petelukk/kellorobo/continuous_track/4hammasta_testi.jpg

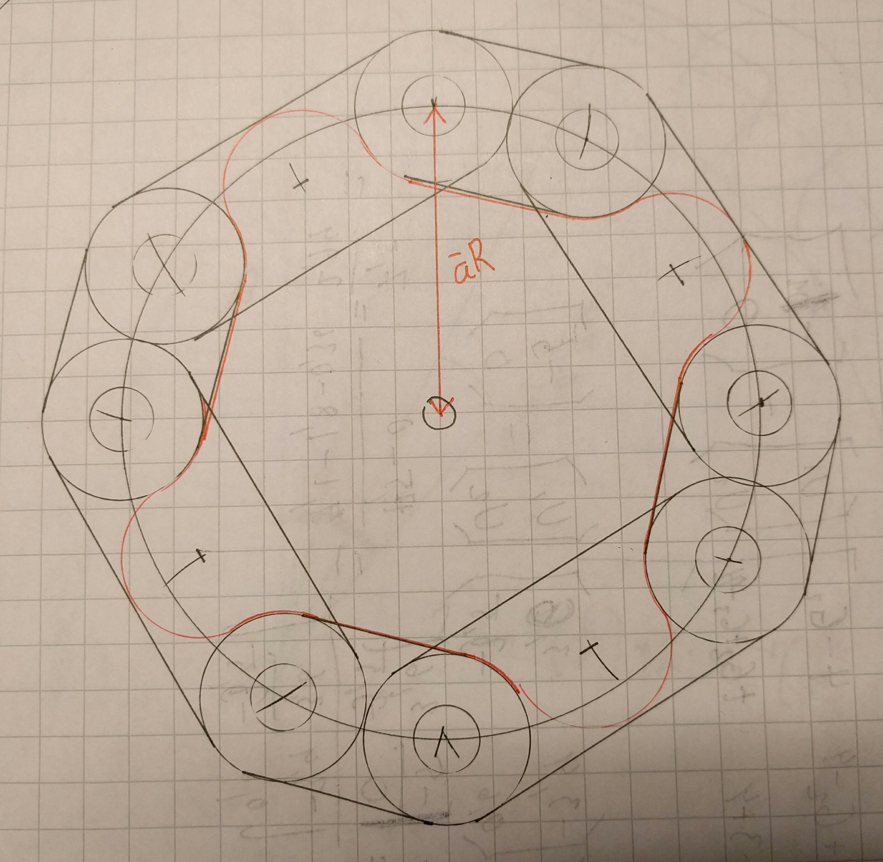
continuous_track/4hammasta_testi.jpg
