petelukk/kellorobo/kuvat/assembling_frame2.jpg

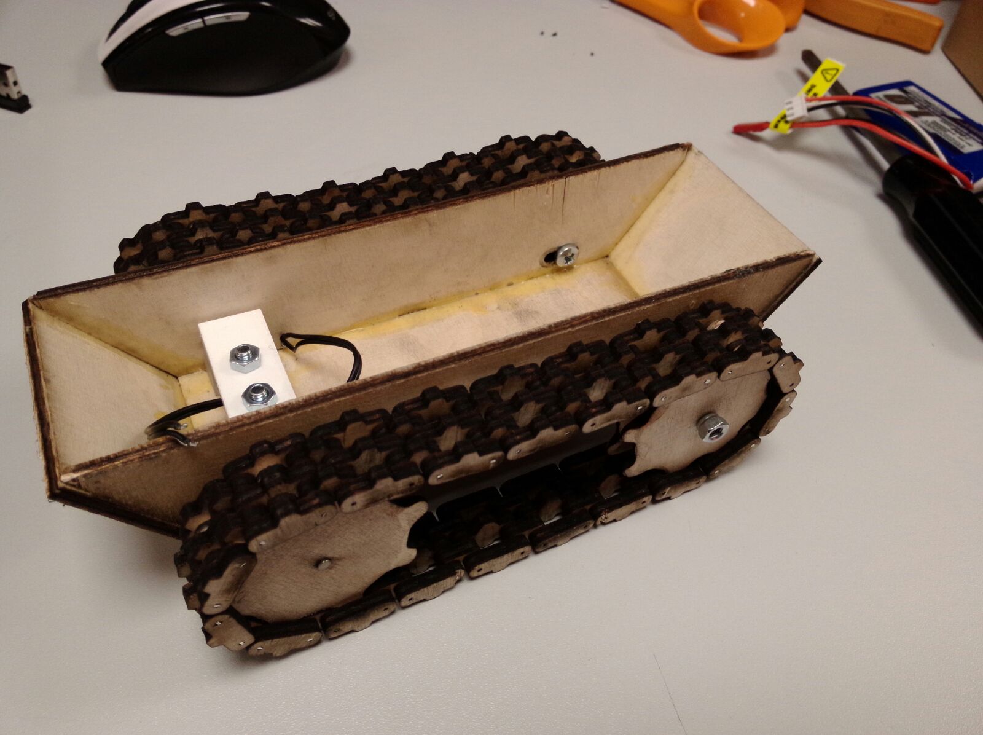
kuvat/assembling_frame2.jpg
