petelukk/kellorobo/workfiles/frame2.pdf

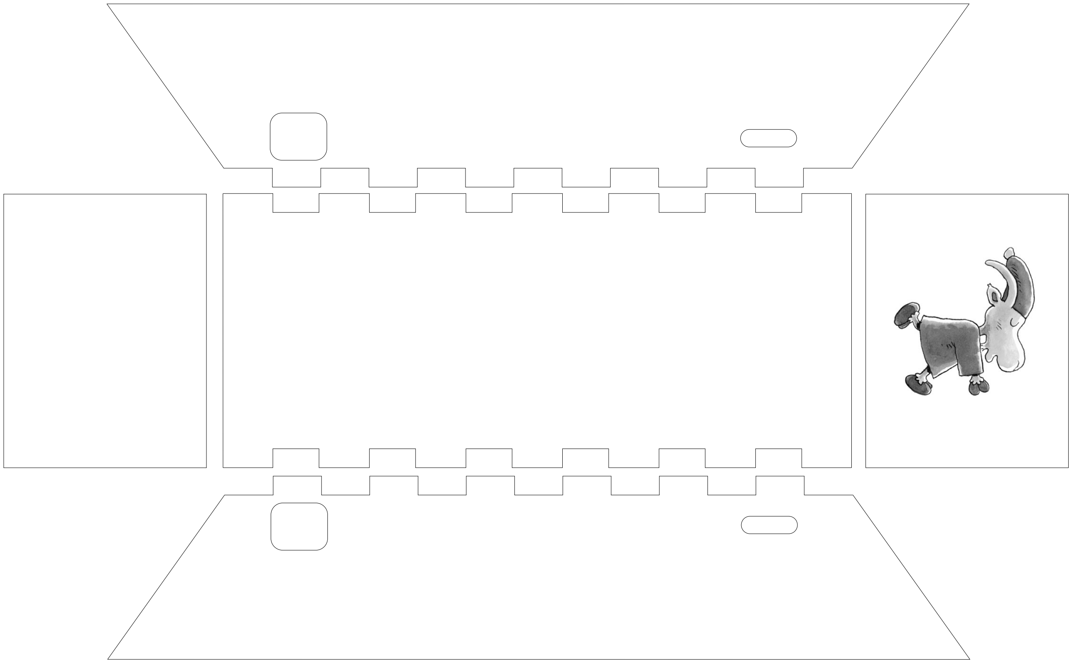
[picture p3: figure]
