petelukk/kellorobo/continuous_track/kaava.jpg

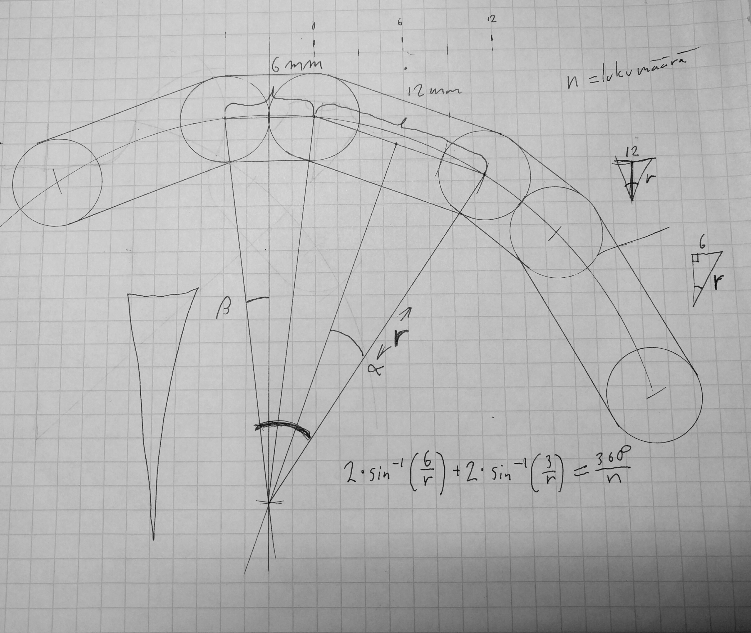
continuous_track/kaava.jpg
