petelukk/kellorobo/continuous_track/sprocket_freecad.png

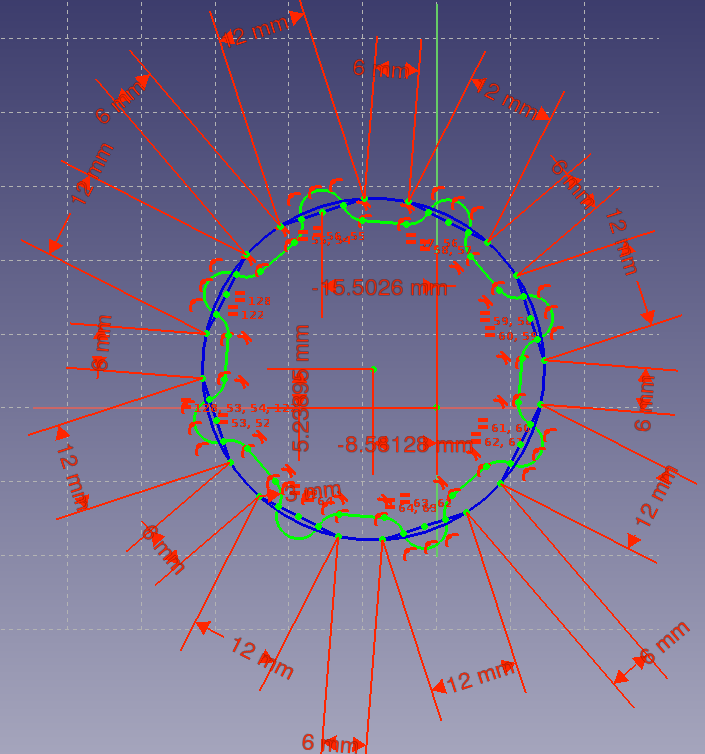
continuous_track/sprocket_freecad.png
