petelukk/kellorobo/kuvat/final1.JPG

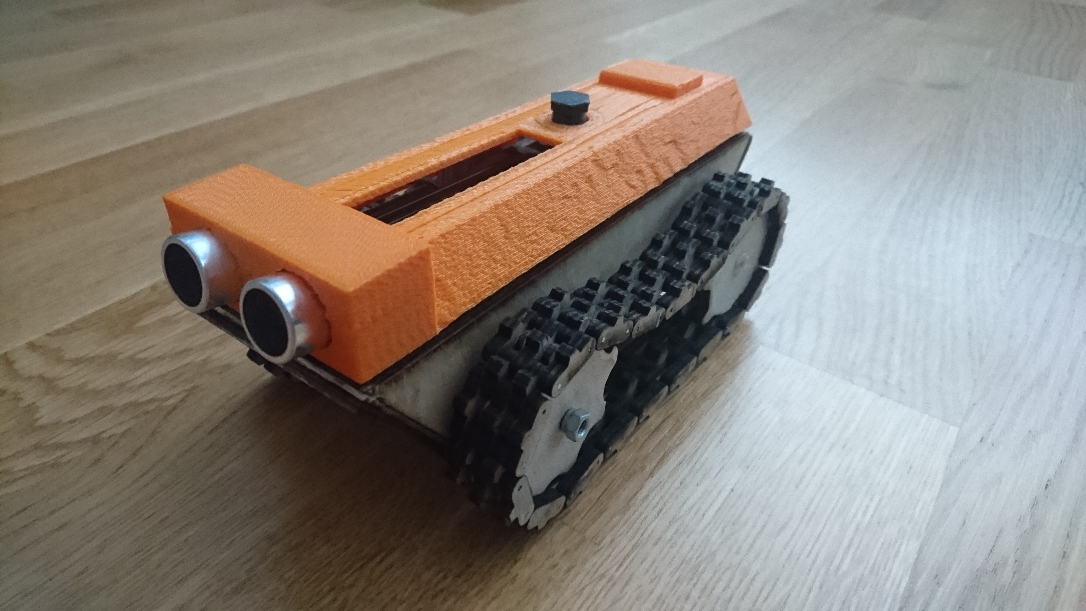
kuvat/final1.JPG
