petelukk/kellorobo/kuvat/final2.JPG

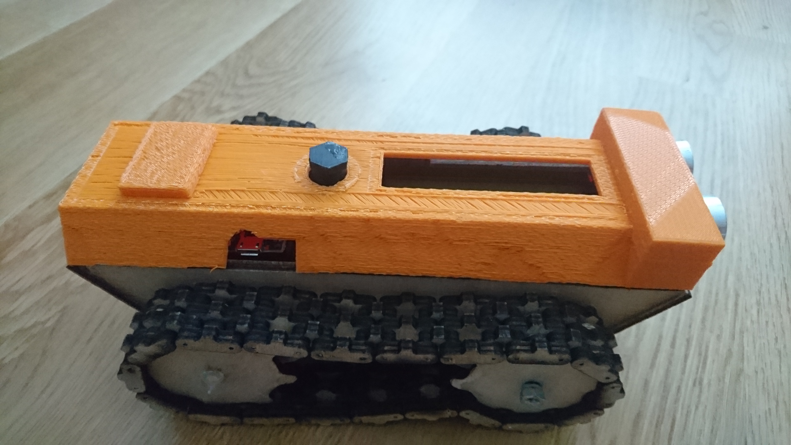
kuvat/final2.JPG
