petelukk/kellorobo/kuvat/final3.JPG

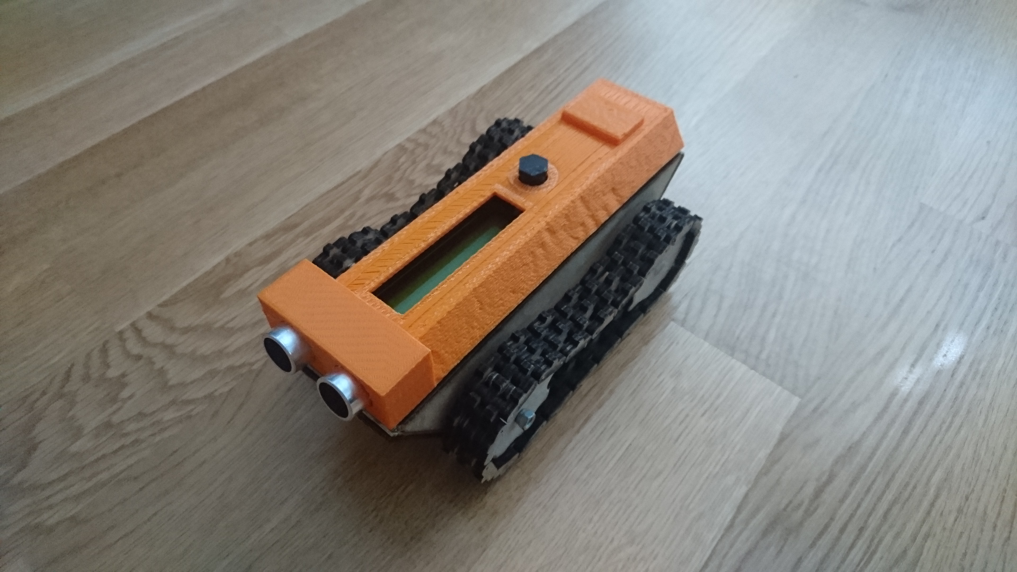
kuvat/final3.JPG
