petelukk/kellorobo/kuvat/final4.JPG

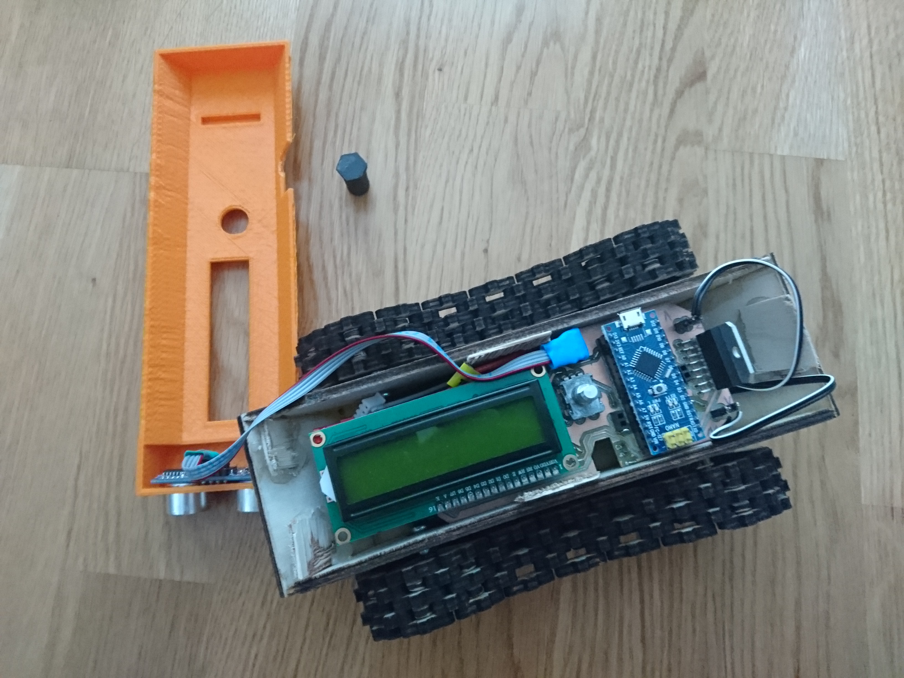
kuvat/final4.JPG
