petelukk/kellorobo/kuvat/final5.JPG

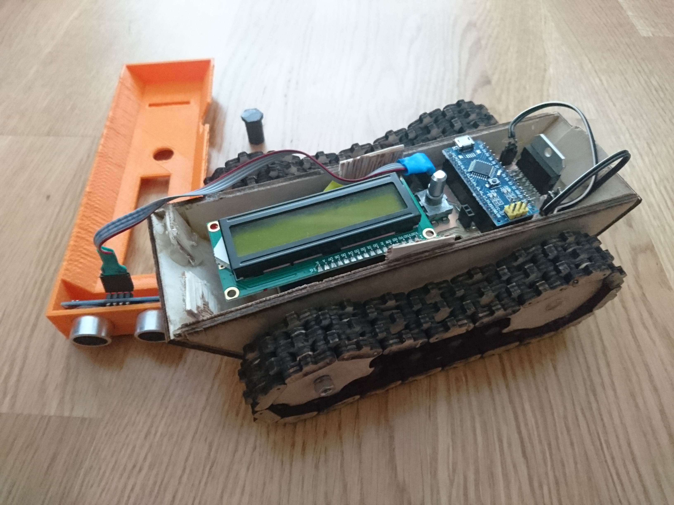
kuvat/final5.JPG
