petelukk/kellorobo/kuvat/final6.JPG

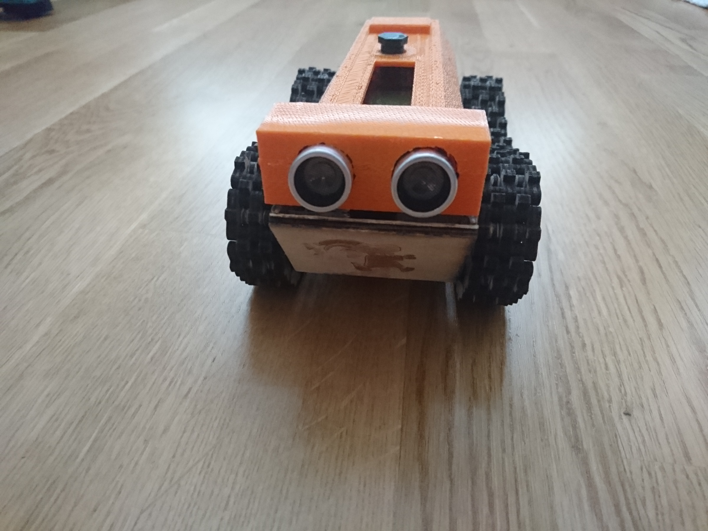
kuvat/final6.JPG
