petelukk/kellorobo/kuvat/frame2_with_tracks.jpg

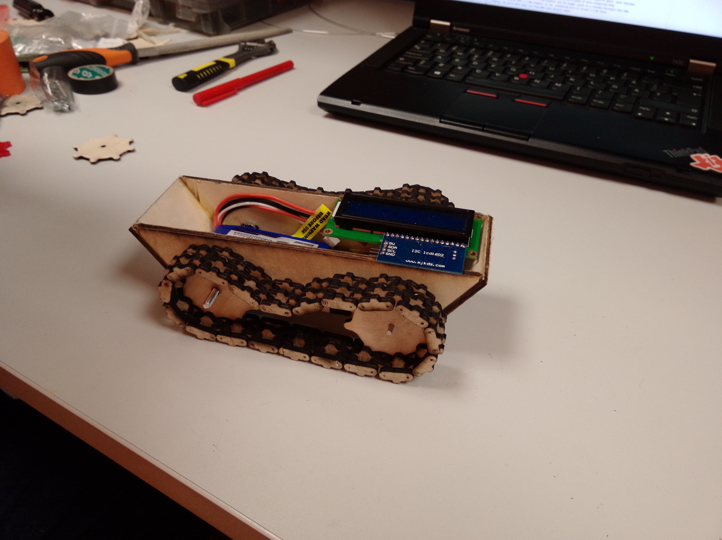
kuvat/frame2_with_tracks.jpg
