petelukk/kellorobo/kuvat/motor_holder.jpg

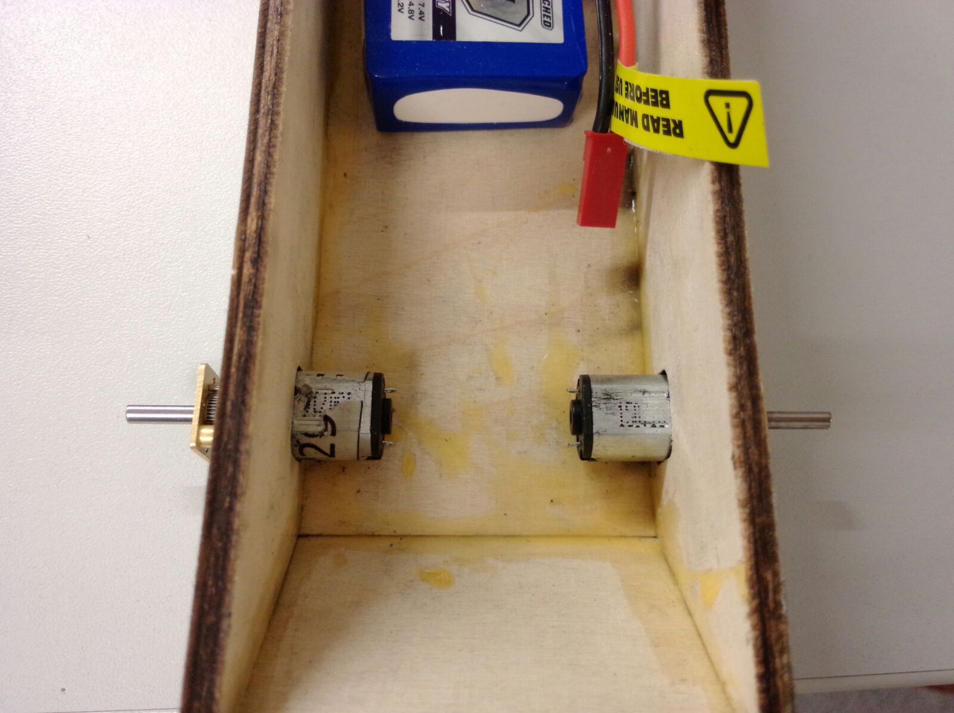
kuvat/motor_holder.jpg
