petelukk/kellorobo/kuvat/track_structure.jpg

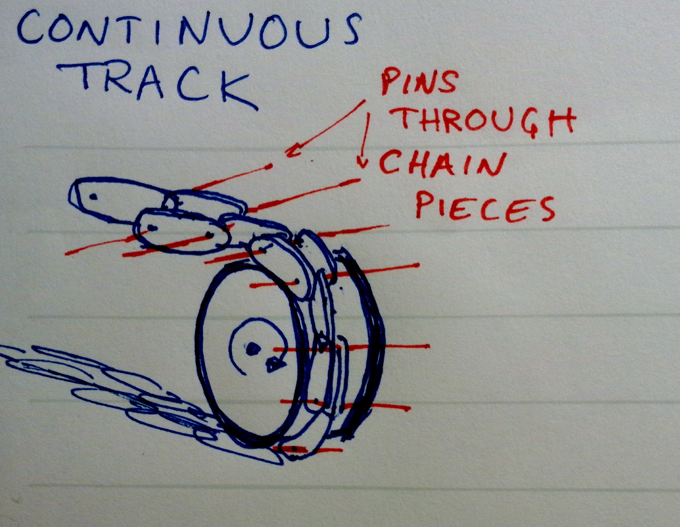
kuvat/track_structure.jpg
