petelukk/kellorobo/pcb/pcb_fäp_files/final/back_cu.png

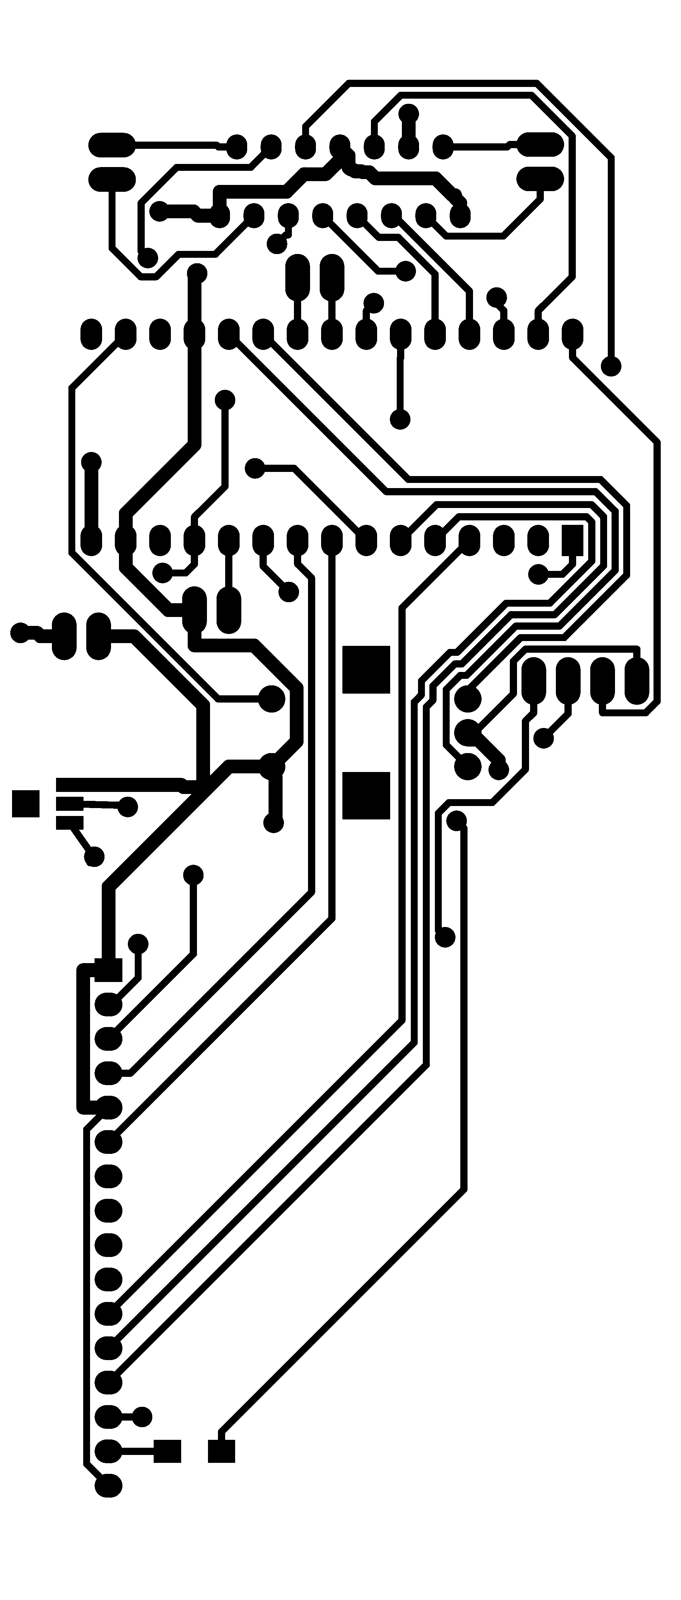
pcb/pcb_fäp_files/final/back_cu.png
