petelukk/kellorobo/pcb/pcb_fäp_files/final/edgecuts.png

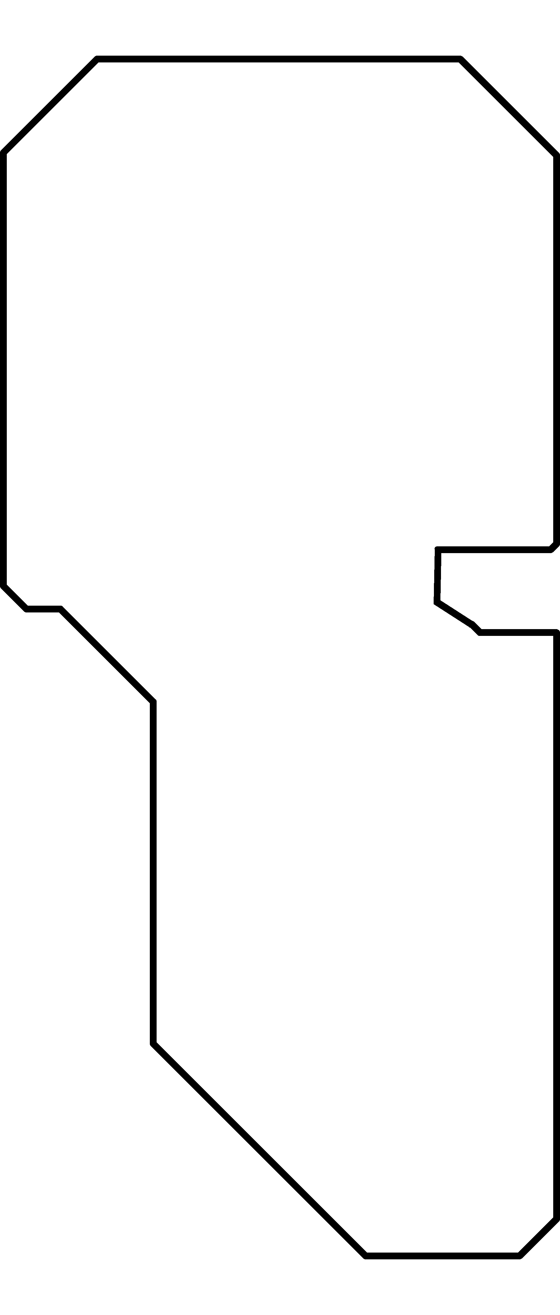
pcb/pcb_fäp_files/final/edgecuts.png
