petelukk/kellorobo/pcb/pcb_fäp_files/final/front_cu.png

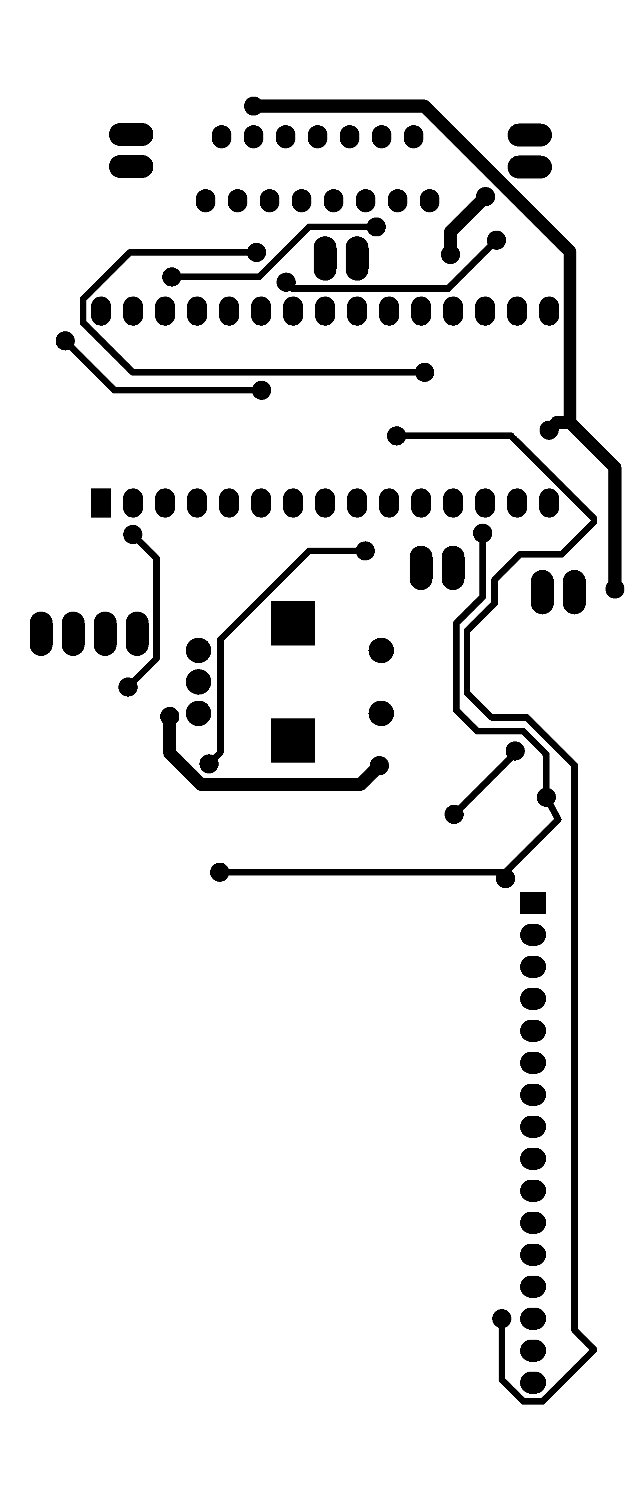
pcb/pcb_fäp_files/final/front_cu.png
