petelukk/kellorobo/pcb/pcb_fäp_files/final/holes_front.png

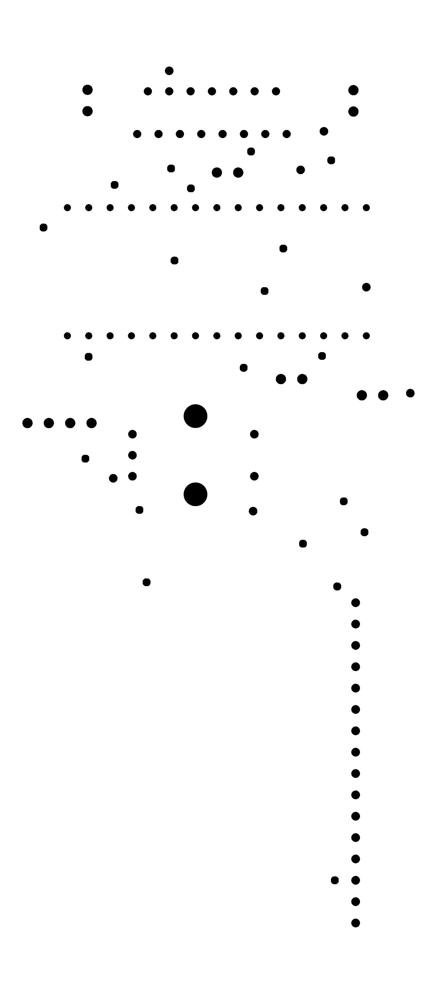
pcb/pcb_fäp_files/final/holes_front.png
