petelukk/kellorobo/workfiles/toplid_v3-cube.stl

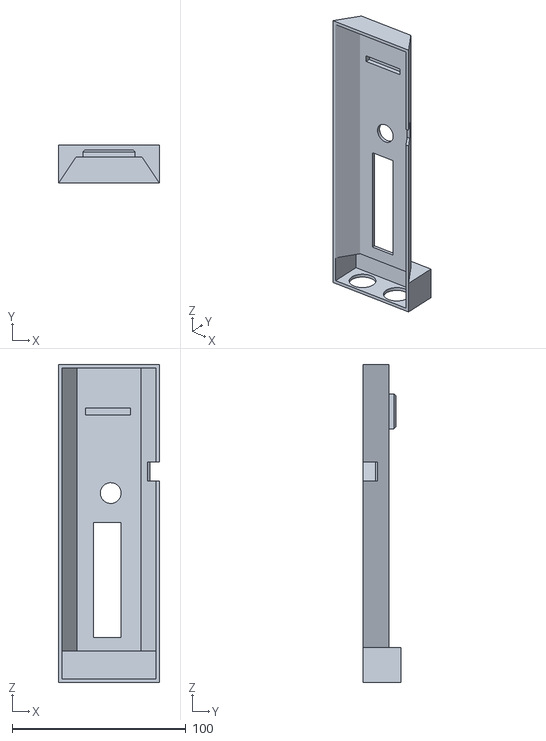
[picture p19: CAD file, 2016-06-07]
workfiles/toplid_v3-cube.stl
58.0 x 22.0 x 183.0
