petelukk/kellorobo/workfiles/rotary_knob.fcstd

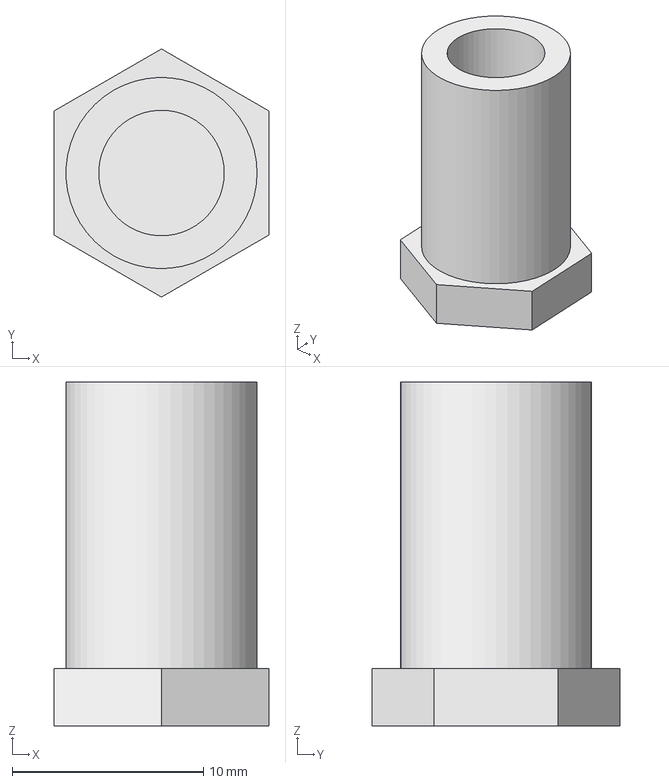
[picture p20: CAD file, 2016-06-07]
workfiles/rotary_knob.fcstd
11.2 x 13.0 x 18.0 mm
