petelukk/kellorobo/workfiles/motor_holder.fcstd

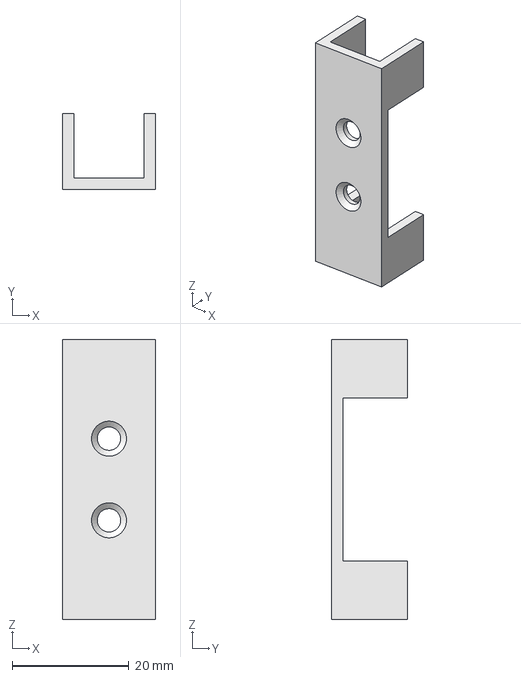
[picture p21: CAD file, 2016-04-21]
workfiles/motor_holder.fcstd
16.0 x 13.0 x 48.0 mm
