petelukk/kellorobo/(list of files, cad)

Other CAD files:
continuous_track/sprocket_freewheel.fcstd
continuous_track/sprocket_separator.fcstd
continuous_track/sprocket_motor_shaft.fcstd
workfiles/toplid_v3.fcstd
continuous_track/motor_axle_size_test.fcstd
continuous_track/sprocket.fcstd
continuous_track/sprocket_big_hole.fcstd
continuous_track/ketju.fcstd
continuous_track/middle_link.fcstd
continuous_track/side_link.fcstd
continuous_track/small_link.fcstd
workfiles/motor_holder.stl
workfiles/rotary_knob.stl
