petelukk/kellorobo/kuvat/assembling_frame.jpg

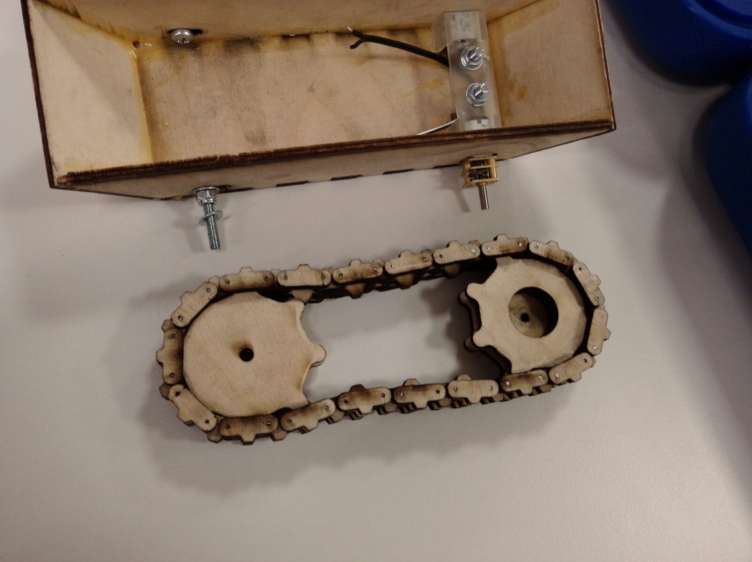
kuvat/assembling_frame.jpg
