petelukk/kellorobo/kuvat/motor_holder_printed.jpg

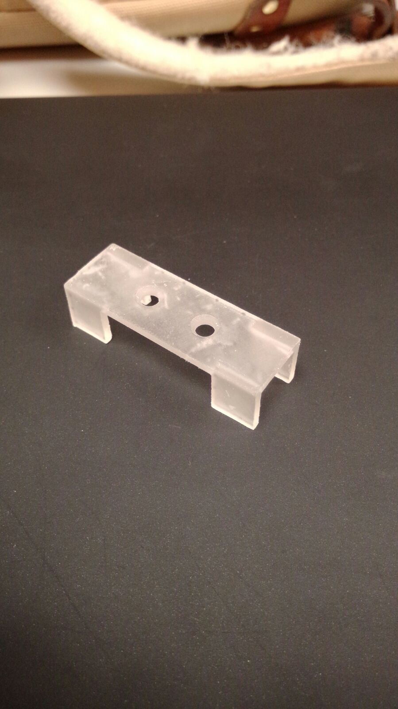
kuvat/motor_holder_printed.jpg
