petelukk/kellorobo/continuous_track/testi_svg.pdf

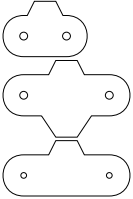
[picture p24: figure]
