petelukk/kellorobo/kuvat/cont_track_2nd_test2.jpg

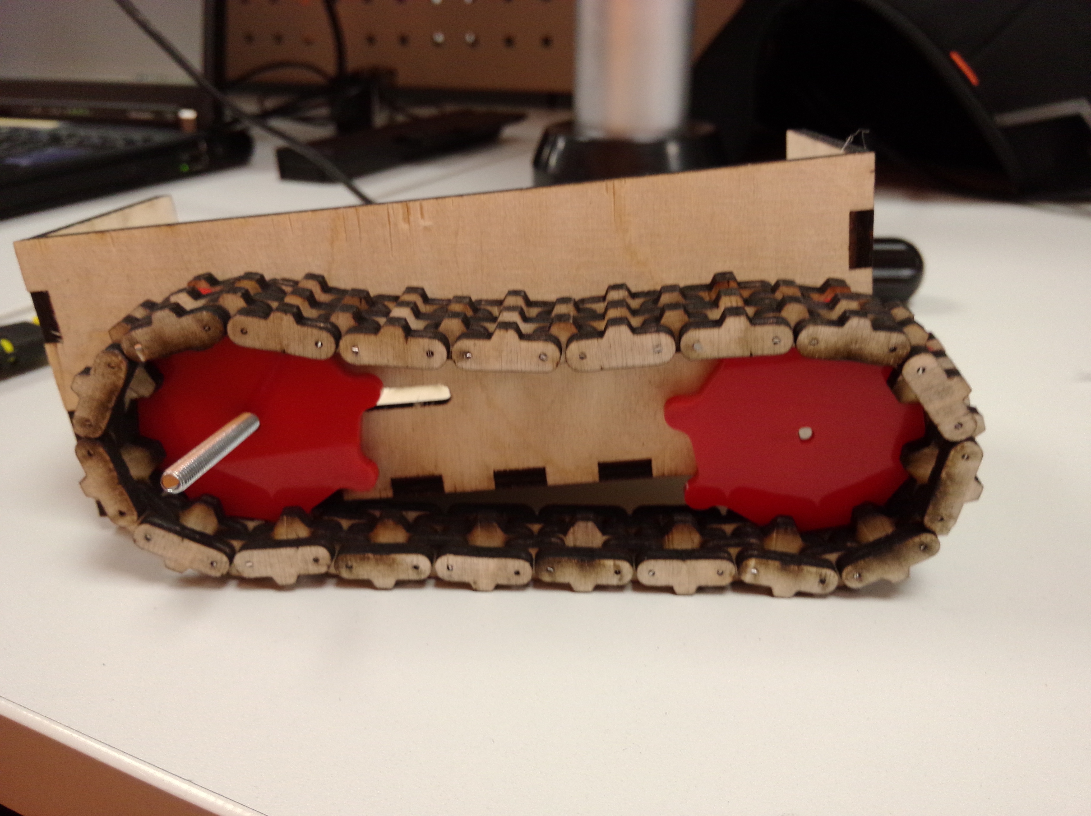
kuvat/cont_track_2nd_test2.jpg
