petelukk/kellorobo/kuvat/cont_track_2nd_test.jpg

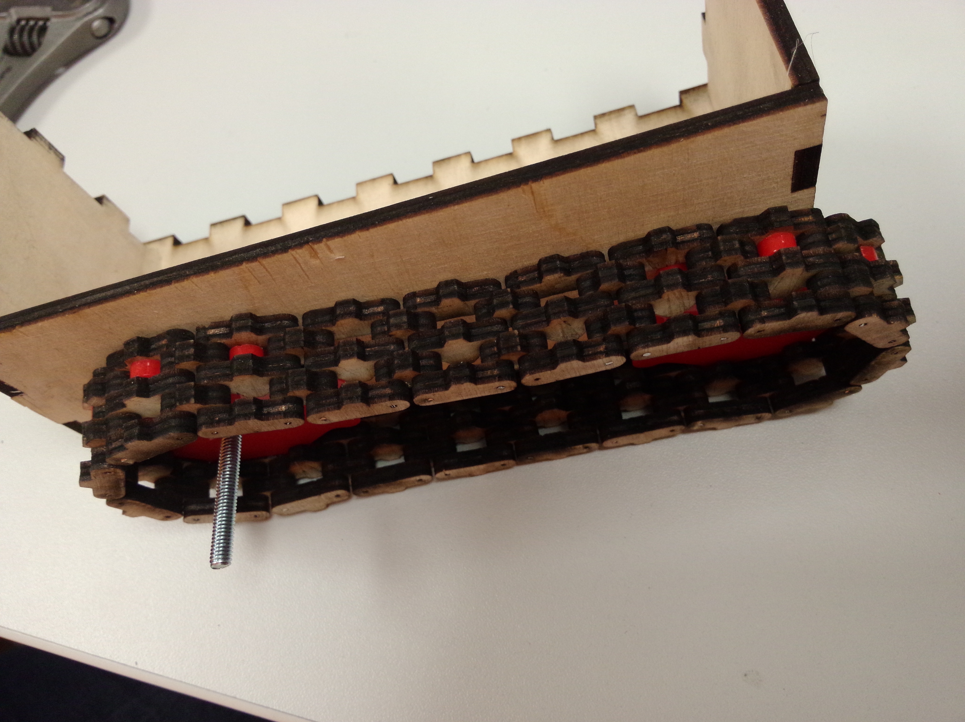
kuvat/cont_track_2nd_test.jpg
