petelukk/kellorobo/kuvat/cont_track_test1.jpg

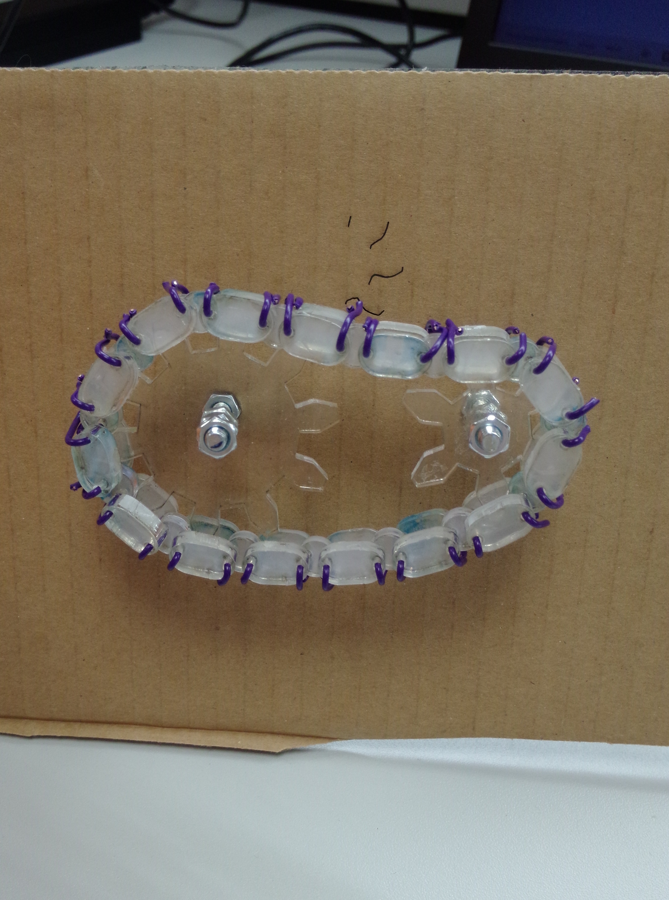
kuvat/cont_track_test1.jpg
