petelukk/kellorobo/kuvat/cont_track_test2.jpg

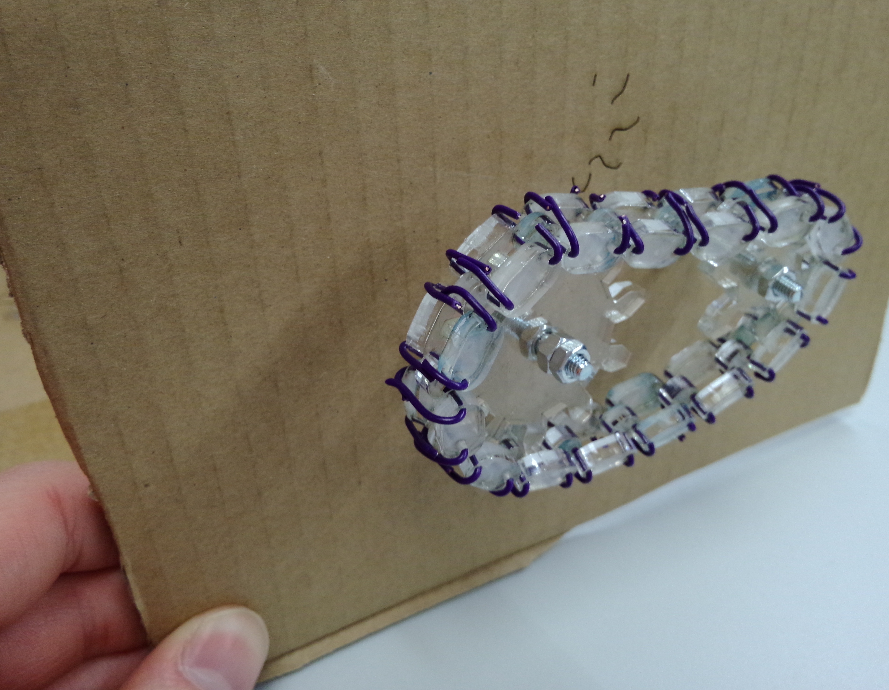
kuvat/cont_track_test2.jpg
