petelukk/kellorobo/workfiles/track_test2.pdf

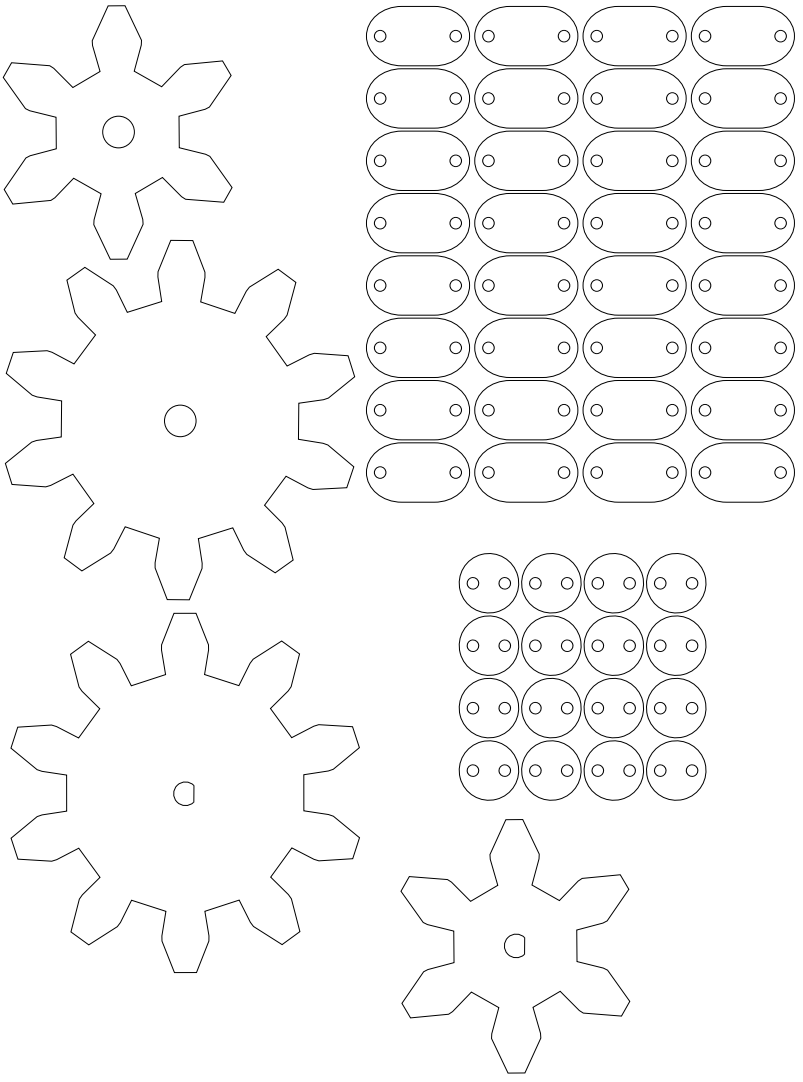
[picture p29: page 1]
