petelukk/kellorobo/continuous_track/sprocket_set.pdf

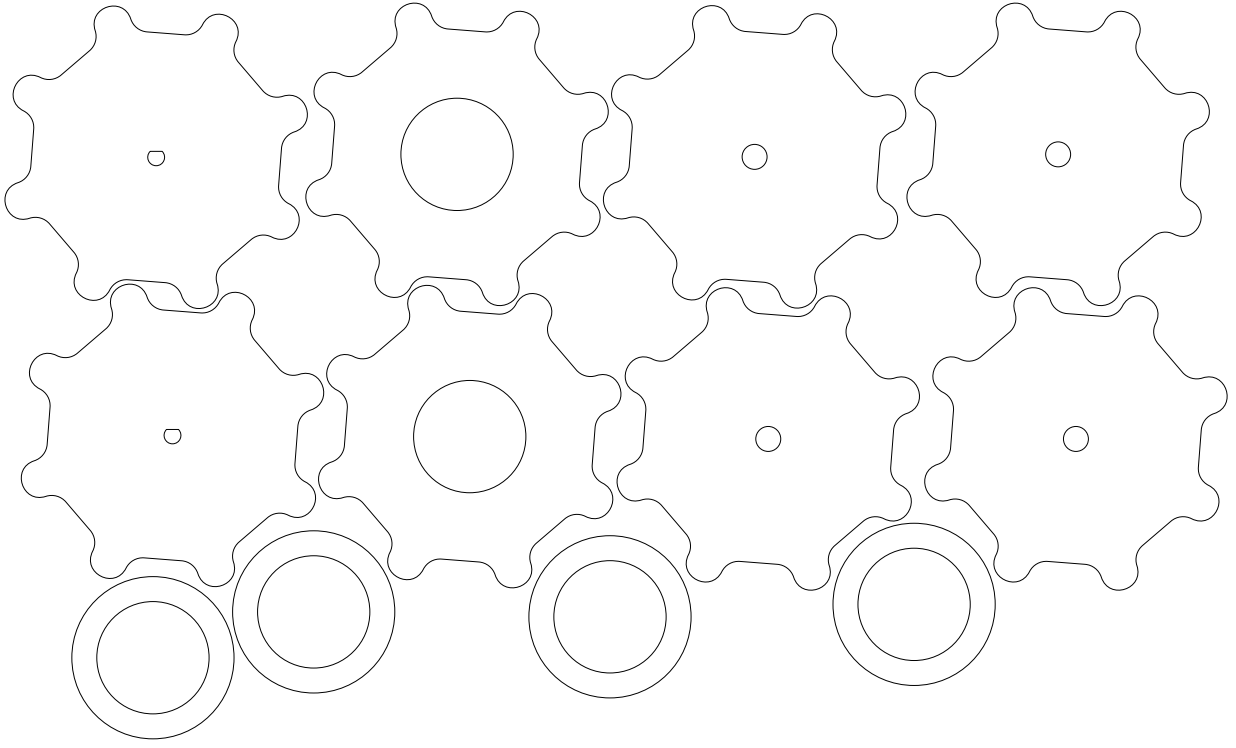
[picture p30: page 1]
