petelukk/kellorobo/workfiles/proto_sprockets.pdf

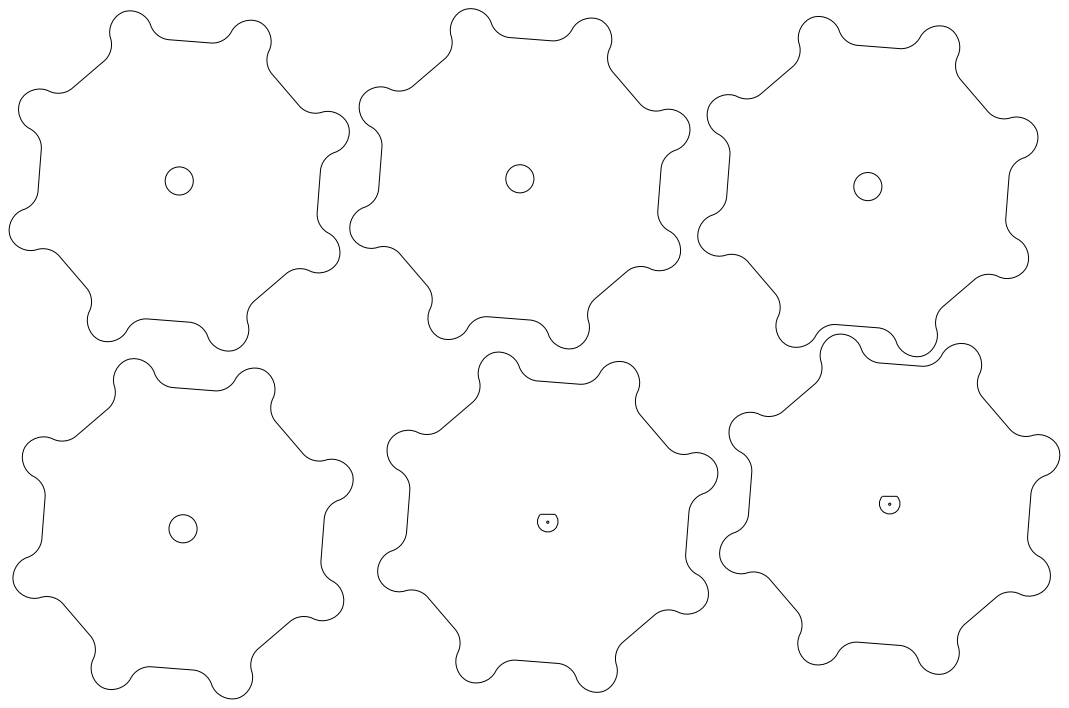
[picture p31: page 1]
