petelukk/kellorobo/continuous_track/leikkuu.pdf

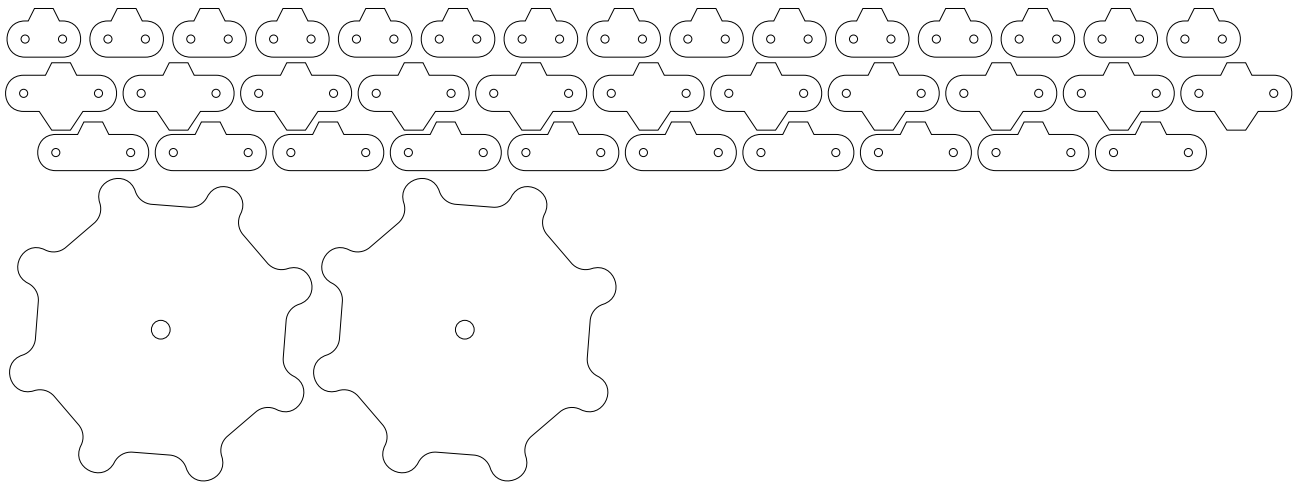
[picture p32: page 1]
