petelukk/kellorobo/continuous_track/track_30_elements.pdf

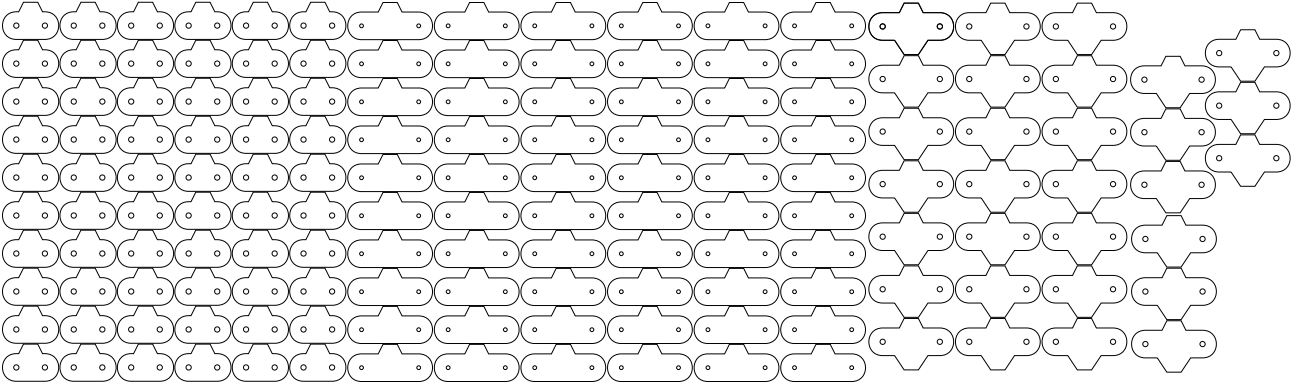
[picture p33: page 1]
