petelukk/kellorobo/(list of files, drawings)

Other design files:
pcb/kellorobo.dsn
