petelukk/kellorobo/pcb/kellorobo.kicad_pcb

## KiCad design pcb/master_module.kicad_pcb

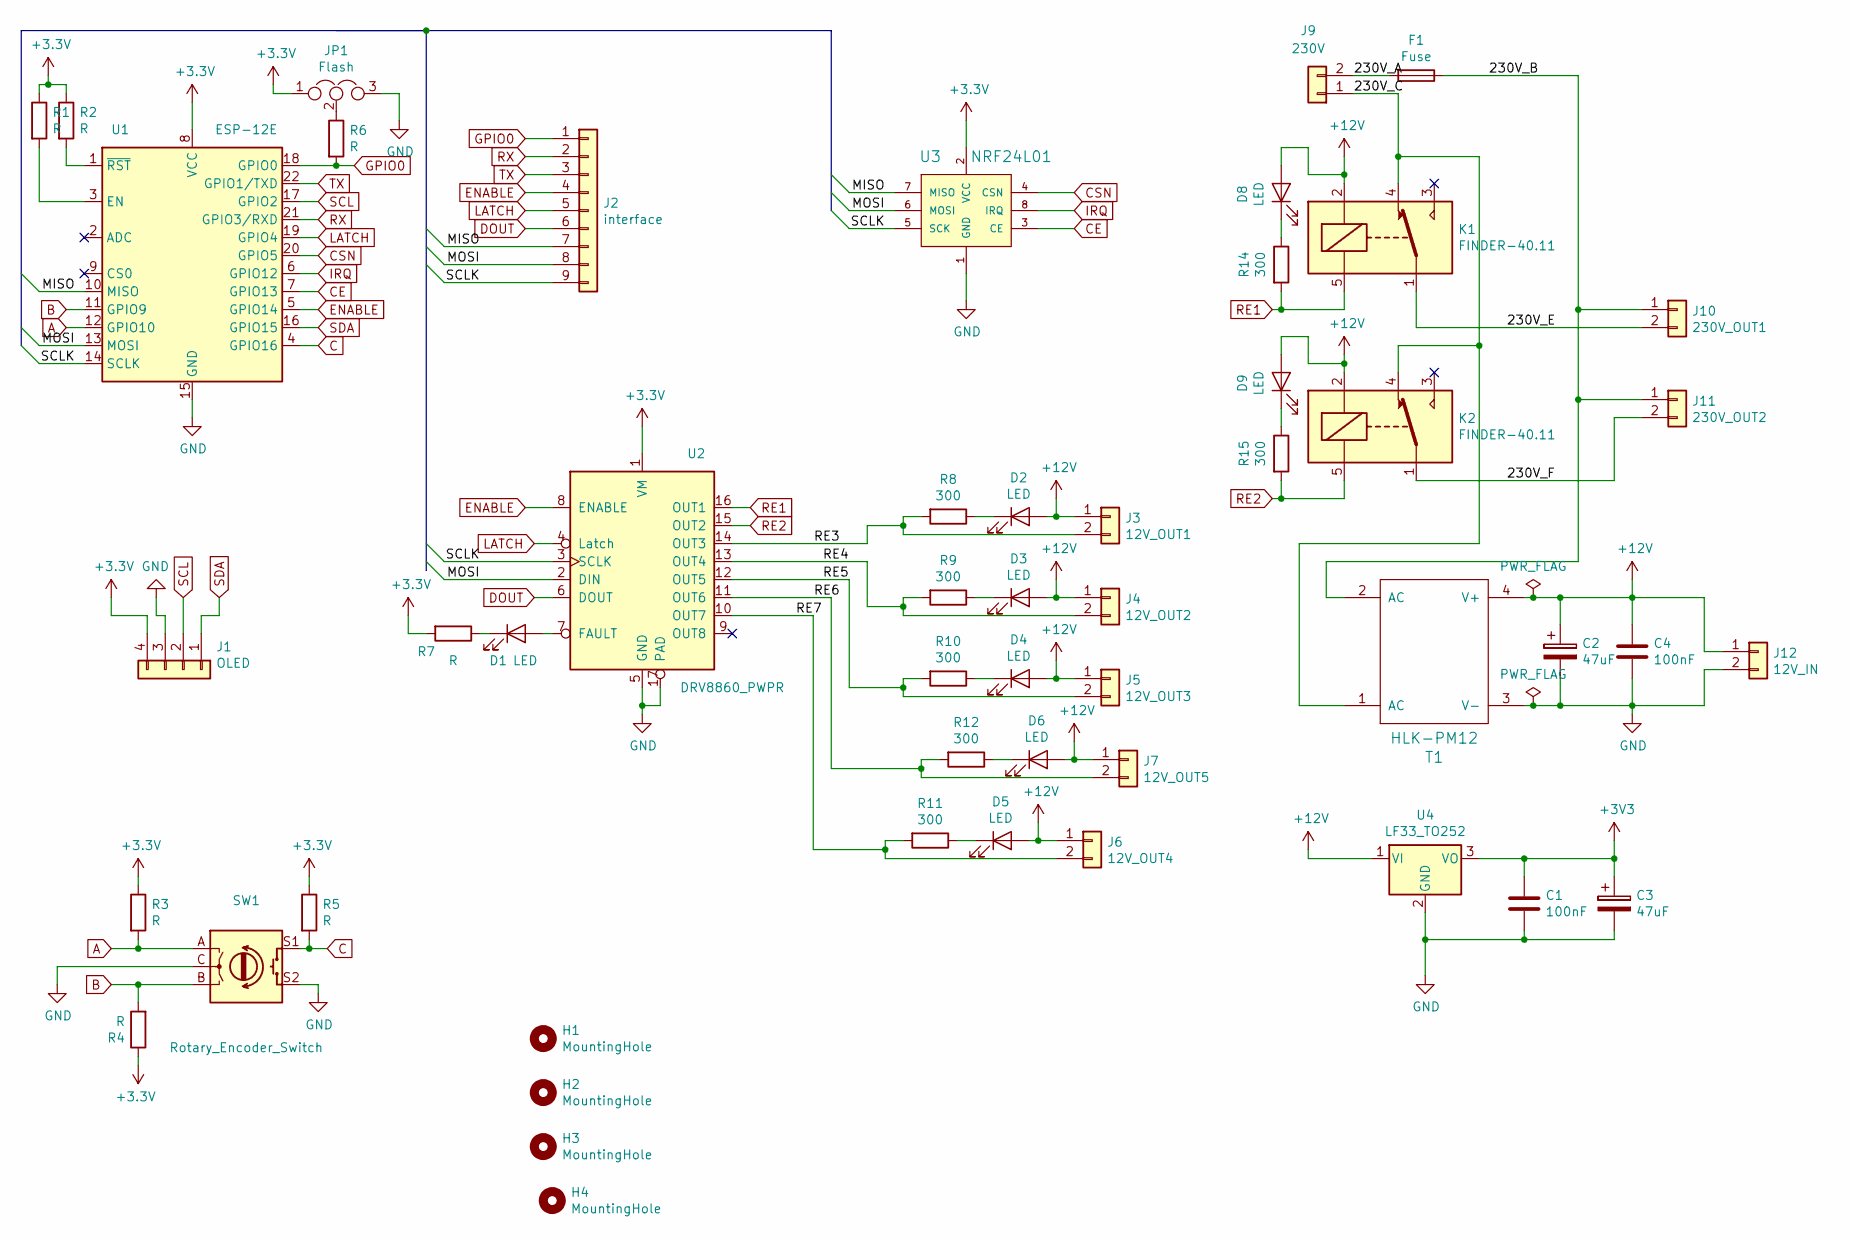
[picture p34: schematic master_module.sch]

Parts:
C1, C4: 100nF; Kondensator_SMD_0805
C2, C3: 47uF; Kondensator_THT_8mm
D1, D2, D3, D4, D5, D6, D8, D9: LED; LED_SMD_1206
F1: Fuse; Sicherung_THT
H1, H2, H3, H4: MountingHole; MountingHole_3.2mm_M3_DIN965
J1: OLED; i2c_oled_1.3Zoll
J2: interface; CON_Stiftleiste_9x1
J3: 12V_OUT1; terminal_block_2pin
J4: 12V_OUT2; terminal_block_2pin
J5: 12V_OUT3; terminal_block_2pin
J6: 12V_OUT4; terminal_block_2pin
J7: 12V_OUT5; terminal_block_2pin
J9: 230V; terminal_block_2pin
J10: 230V_OUT1; terminal_block_2pin
J11: 230V_OUT2; terminal_block_2pin
J12: 12V_IN; terminal_block_2pin
JP1: Flash; CON_Stiftleiste_3x1
K1, K2: FINDER-40.11; Relay_SPDT_Omron-G5LE-1
R1, R2, R3, R4, R5, R6, R7: R; Wiederstand_SMD_0805
R8, R9, R10, R11, R12, R14, R15: 300; Wiederstand_SMD_0805
SW1: Rotary_Encoder_Switch; RotaryEncoder_Alps_EC11E-Switch_Vertical_H20mm
T1: HLK-PM12
U1: ESP-12E
U2: DRV8860_PWPR; TSSOP-16-1EP_4.4x5mm_P0.65mm
U3: NRF24L01; NRF24L01-SMD
U4: LF33_TO252; TO-252-2

Connections:
+12V: C2.1, C4.1, D2.2 (A), D3.2 (A), D4.2 (A), D5.2 (A), D6.2 (A), D8.2 (A), D9.2 (A), J3.1, J4.1, J5.1, J6.1, J7.1, J12.1, K1.2, K2.2, T1.4 (V+), U4.1 (VI)
/230V_A: F1.2, J9.2
/230V_B: F1.1, J10.1, J11.1, T1.2 (AC)
/230V_C: J9.1, K1.4, K2.4, T1.1 (AC)
/230V_E: J10.2, K1.1
/230V_F: J11.2, K2.1
/MISO: J2.7, U1.10 (MISO), U3.7 (MISO)
/MOSI: J2.8, U1.13 (MOSI), U2.2 (DIN), U3.6 (MOSI)
/RE3: J3.2, R8.2, U2.14 (OUT3)
/RE4: J4.2, R9.2, U2.13 (OUT4)
/RE5: J5.2, R10.2, U2.12 (OUT5)
/RE6: J7.2, R12.2, U2.11 (OUT6)
/RE7: J6.2, R11.2, U2.10 (OUT7)
/SCLK: J2.9, U1.14 (SCLK), U2.3 (SCLK), U3.5 (SCK)
A: R3.2, SW1.A, U1.12 (GPIO10)
B: R4.2, SW1.B, U1.11 (GPIO9)
C: R5.2, SW1.S1, U1.4 (GPIO16)
CE: U1.7 (GPIO13), U3.3 (CE)
CSN: U1.20 (GPIO5), U3.4 (CSN)
DOUT: J2.6, U2.6 (DOUT)
ENABLE: J2.4, U1.5 (GPIO14), U2.8 (ENABLE)
GND: C1.2, C2.2, C3.2, C4.2, J1.3, J12.2, JP1.3, SW1.C, SW1.S2, T1.3 (V-), U1.15 (GND), U2.5 (GND), U2.17 (PAD), U3.1 (GND), U4.2 (GND)
GPIO0: J2.1, R6.2, U1.18 (GPIO0)
IRQ: U1.6 (GPIO12), U3.8 (IRQ)
LATCH: J2.5, U1.19 (GPIO4), U2.4 (Latch)
unnamed: D1.1 (K), R7.1
unnamed: D1.2 (A), U2.7 (FAULT)
unnamed: D2.1 (K), R8.1
unnamed: D3.1 (K), R9.1
unnamed: D4.1 (K), R10.1
unnamed: D5.1 (K), R11.1
unnamed: D6.1 (K), R12.1
unnamed: D8.1 (K), R14.1
unnamed: D9.1 (K), R15.1
unnamed: JP1.2, R6.1
unnamed: R1.2, U1.3 (EN)
unnamed: R2.2, U1.1 (~RST)
RE1: K1.5, R14.2, U2.16 (OUT1)
RE2: K2.5, R15.2, U2.15 (OUT2)
RX: J2.2, U1.21 (GPIO3/RXD)
SCL: J1.2, U1.17 (GPIO2)
SDA: J1.1, U1.16 (GPIO15)
TX: J2.3, U1.22 (GPIO1/TXD)

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
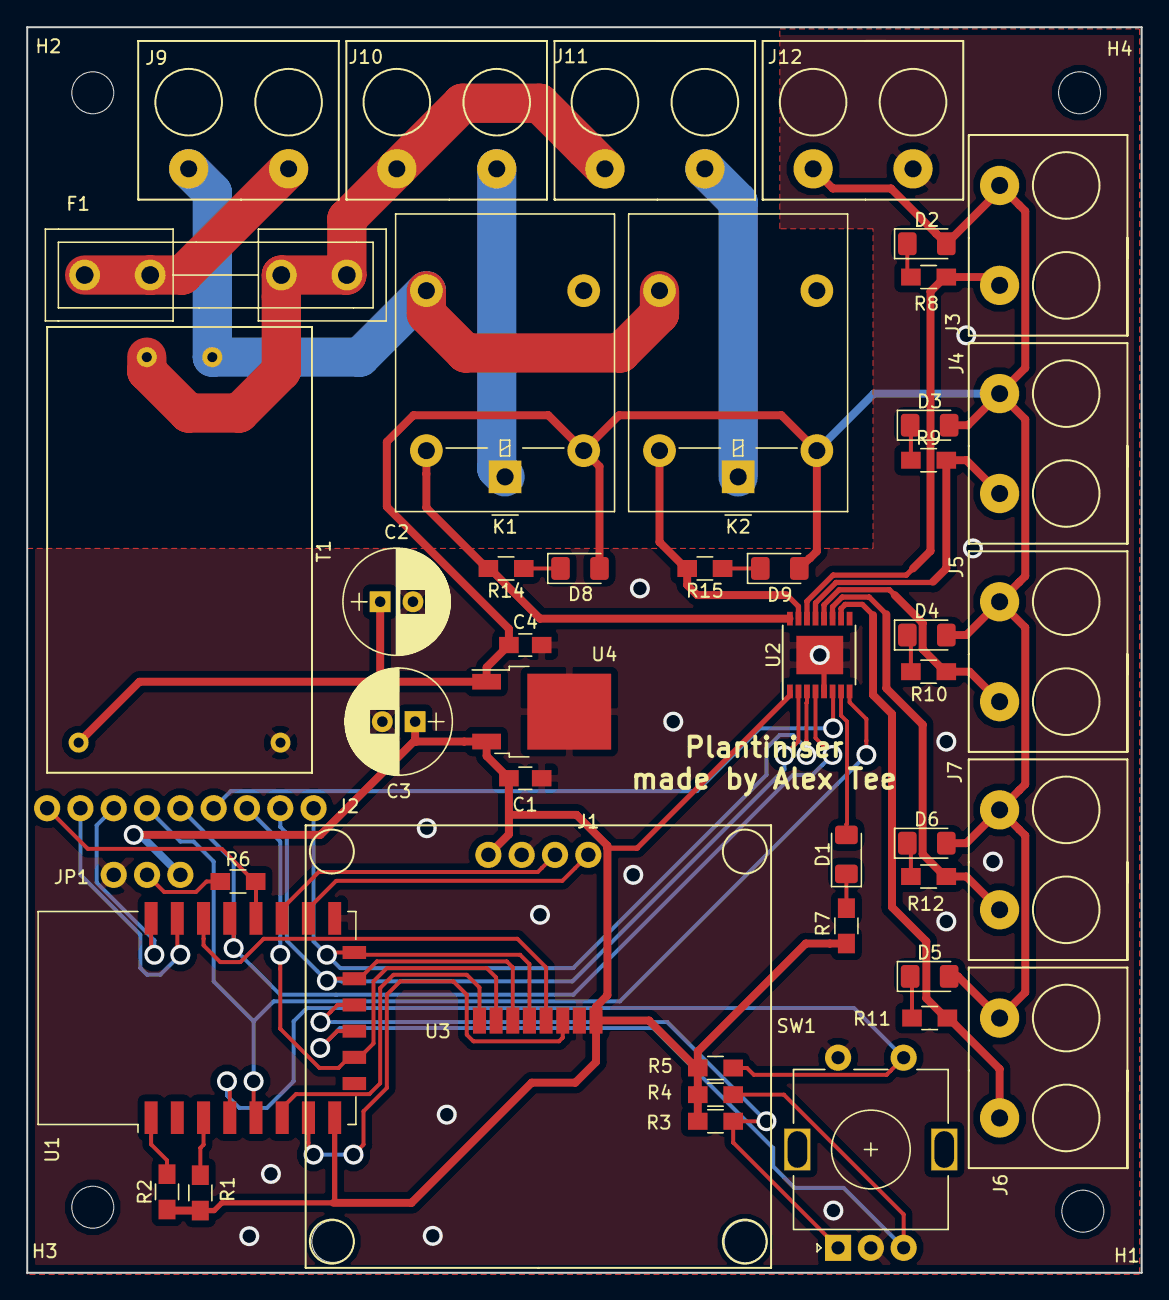
[picture p35: board master_module.kicad_pcb from above]

Board: 2 copper layers, 85.0 x 95.0 mm, 51 parts (0 on the bottom side), 44 nets.
