petelukk/kellorobo/pcb/kellorobo.kicad_pcb

## KiCad design master_module/PCB/watering_system.kicad_pcb

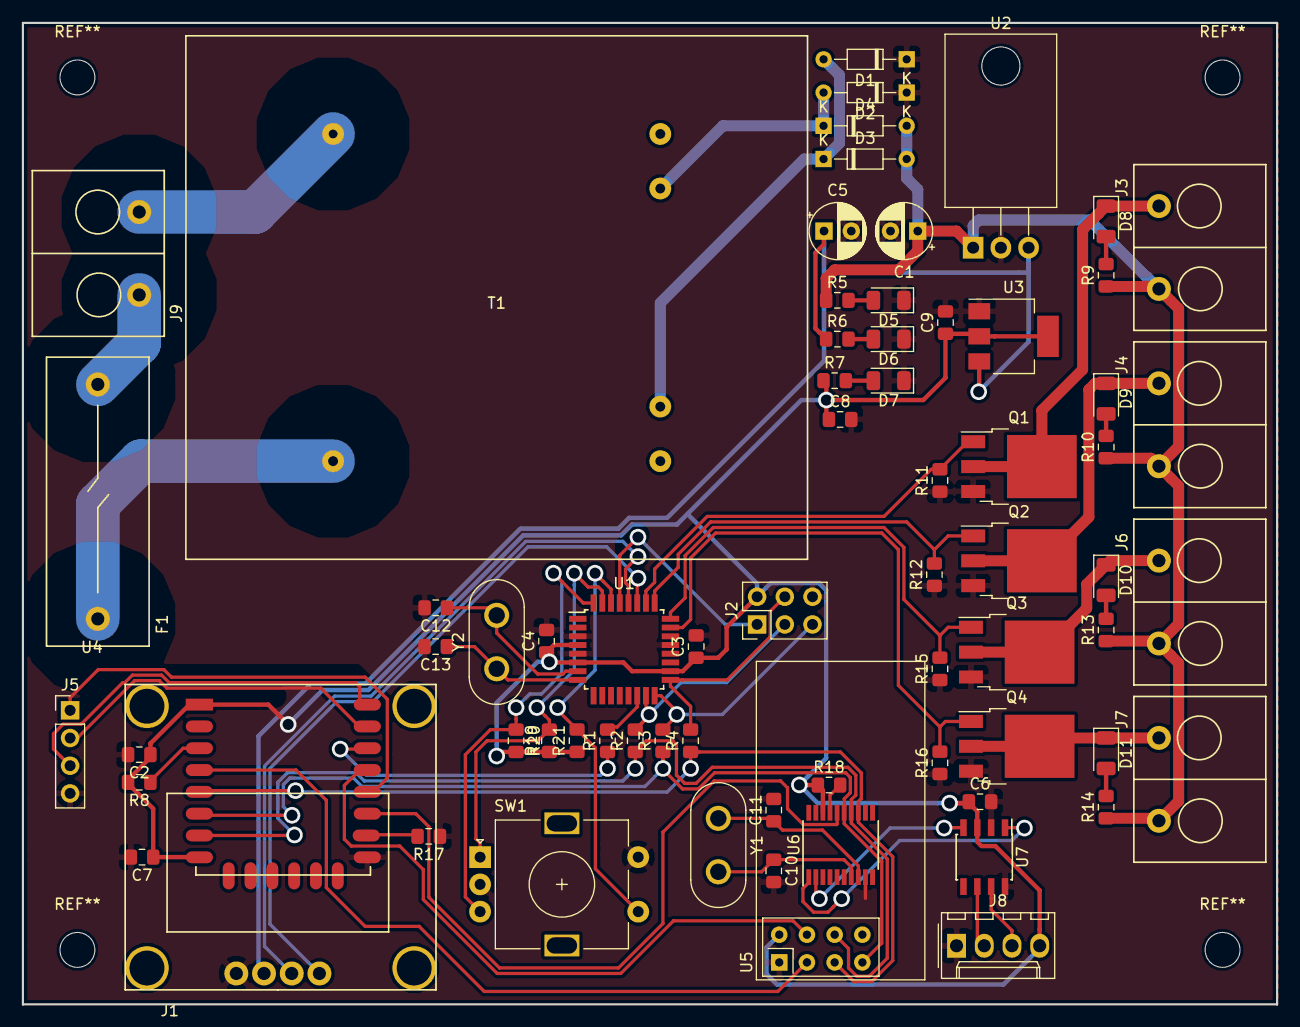
[picture p36: board watering_system.kicad_pcb from above]

Board: 2 copper layers, 115.0 x 90.0 mm, 70 parts (0 on the bottom side), 55 nets.

Parts:
C1, C5: 47u; CP_Radial_D5.0mm_P2.50mm
C2, C3, C4, C6, C7, C8, C9: 100n; C_0805_2012Metric_Pad1.15x1.40mm_HandSolder
C10, C11, C12, C13: 22p; C_0805_2012Metric_Pad1.15x1.40mm_HandSolder
D1, D2, D3, D4: DIODE; D_DO-34_SOD68_P7.62mm_Horizontal
D5, D6, D7, D8, D9, D10, D11: LED; LED_1206_3216Metric
F1: Fuse; fuse
J1: Oled; i2c_oled_0_95_inch
J2: AVR-ISP-6; PinHeader_2x03_P2.54mm_Vertical
J3: A1_CON; HP_Connector_2pin
J4: A2_CON; HP_Connector_2pin
J5: esp_serial; PinHeader_1x04_P2.54mm_Vertical
J6: A3_CON; HP_Connector_2pin
J7: A4_CON; HP_Connector_2pin
J8: CAN; Molex_KK-254_AE-6410-04A_1x04_P2.54mm_Vertical
J9: MAINS; HP_Connector_2pin
Q1, Q2, Q3, Q4: IRFR1205; TO-252-3_TabPin2
R1, R2, R3, R4, R5, R8, R9, R10, R11, R12, R13, R14, R15, R16, R17, R18, R19, R20, R21: 1k; R_0805_2012Metric_Pad1.15x1.40mm_HandSolder
R6, R7: 330; R_0805_2012Metric_Pad1.15x1.40mm_HandSolder
SW1: Rotary_Encoder_Switch; RotaryEncoder_Alps_EC11E-Switch_Vertical_H20mm
T1: Transformer_1P_1S; PrintTrafo_16VA
U1: ATmega8-16AU; TQFP-32_7x7mm_P0.8mm
U2: L7805; TO-220-3_Horizontal_TabDown
U3: LD1117S33TR_SOT223; SOT-223-3_TabPin2
U4: ESP-12; ESP-12E
U5: NRF24L01_Breakout; nRF24L01_Breakout
U6: MCP2515-EST; TSSOP-20_4.4x6.5mm_P0.65mm
U7: TJA1051T; SOIC-8_3.9x4.9mm_P1.27mm
Y1, Y2: 16Mhz; Crystal_HC50_Vertical

Connections:
+3V3: C2.1, C3.1, C4.1, C6.1, C7.1, C8.1, C9.1, J2.2, J8.4, R7.1, R8.2, R18.1, R19.1, R20.2, R21.1, U1.4, U1.6, U1.18, U3.2, U4.1, U4.8, U5.2, U6.18, U7.3
+5V: C5.1, J1.2, R6.1, U2.3, U3.3
+12V: C1.1, D3.2, D4.2, J3.2, J4.2, J6.2, J7.2, R5.1, R9.1, R10.1, R13.1, R14.1, U2.1
/CE_NRF: U4.4, U5.3
/MISO: R3.1, U4.6, U5.7, U6.15
/MOSI: R2.1, U4.7, U5.6, U6.14
/SCK: R4.1, U4.5, U5.5, U6.13
/SS_AVR: R1.1, U4.14
/SS_CAN: U4.11, U6.16
/SS_NRF: U4.13, U5.4
A1: Q1.1, R11.2, U1.26
A2: Q2.1, R12.2, U1.25
A3: Q3.1, R15.2, U1.24
A4: Q4.1, R16.2, U1.23
EA: R19.2, SW1.A, U1.31
EB: R20.1, SW1.B, U1.32
ES: R21.2, SW1.S1, U1.30
GND: C1.2, C2.2, C3.2, C4.2, C5.2, C6.2, C7.2, C8.2, C9.2, C10.2, C11.2, C12.2, C13.2, D1.1, D2.1, D5.1, D6.1, D7.1, J1.1, J2.6, J5.4, J8.1, Q1.3, Q2.3, Q3.3, Q4.3, R11.1, R12.1, R15.1, R16.1, R17.1, SW1.C, SW1.S2, U1.3, U1.5, U1.21, U2.2, U3.1, U4.9, U5.1, U6.9, U7.2, U7.8
unnamed: C10.1, U6.7, Y1.2
unnamed: C11.1, U6.8, Y1.1
unnamed: C12.1, U1.7, Y2.2
unnamed: C13.1, U1.8, Y2.1
unnamed: D1.2, D3.1, T1.3
unnamed: D2.2, D4.1, T1.4
unnamed: D5.2, R5.2
unnamed: D6.2, R6.2
unnamed: D7.2, R7.2
unnamed: D8.1, J3.1, Q1.2
unnamed: D8.2, R9.2
unnamed: D9.1, J4.1, Q2.2
unnamed: D9.2, R10.2
unnamed: D10.1, J6.1, Q3.2
unnamed: D10.2, R13.2
unnamed: D11.1, J7.1, Q4.2
unnamed: D11.2, R14.2
unnamed: F1.1, T1.1
unnamed: F1.2, J9.1
unnamed: J2.1, U1.29
unnamed: J2.3, R2.2, U1.15
unnamed: J2.4, R4.2, U1.17
unnamed: J2.5, R3.2, U1.16
unnamed: J5.1, U4.12
unnamed: J5.2, U4.15
unnamed: J5.3, U4.16
unnamed: J8.2, U7.6
unnamed: J8.3, U7.7
unnamed: J9.2, T1.2
unnamed: R1.2, U1.14
unnamed: R8.1, U4.3
unnamed: R17.2, U4.10
unnamed: R18.2, U6.17
unnamed: U6.1, U7.1
unnamed: U6.2, U7.4
SCL: J1.3, U1.28
SDA: J1.4, U1.27
