petelukk/kellorobo/(commit log)

2016-04-01 Proof of consept of a DIY continuous track
2016-04-01 Proof of concept of a continuous track
    Succesful
2016-04-02 continuous track test cut files
    PDF for Epilog laser cutter
2016-04-02 I drew new version of continuous track.
    [ketju.fcstd]
2016-04-02 Add pictures of continuos track planning and calculations
    [sprocket.fcstd]
2016-04-03 Added pins to track to keep it aligned with the wheels and drew sprocket.
    [ketju.fcstd, middle_link.fcstd, side_link.fcstd, small_link.fcstd, sprocket.fcstd]
2016-04-07 Added manufacturing files of the continuous track. §
    [ketju.fcstd, sprocket.fcstd]
2016-04-10 Proto case and sprockets 8.4.2016
    Added manufacturing files for proto case and sprockets. Drawn in FreeCAD and inkscape. The case did not work out that well since the motors barely fit in.
2016-04-10 Second try at continuous track
    A prototype case, gears and track. 5-row chain cut from 4mm plywood, connected with 1.25mm aluminum welding wire. Gears cut from 3mm acrylic sheet to allow some free play.
2016-04-12 Renamed telaketju to Continuous_track
    [ketju.fcstd, middle_link.fcstd, side_link.fcstd, small_link.fcstd, sprocket.fcstd]
2016-04-19 Second frame
    Second version of frame. Drawn with inkscape - cut from 4 mm plywood.
    Features:
    - strurdier placement for motors
    - chamfered ends
    - more compact than the first proto frame
    No lid included in this frame since the lid will be 3D-printed.
2016-04-21 Second frame with tracks on
    The LCD is on the frame just for show
2016-04-21 Motor holder
    Made a little piece to hold the motors in place inside the case. Two holes for fastening purposes. See picture "motor_holder.jpg" to see where this is going to be placed. Made with FreeCAD but not yet printed.
    [motor_holder.fcstd, motor_holder.stl]
2016-04-21 Motor holder
    The motor holder is going to placed here to fasten the motors to the case.
2016-04-29 Printed motor holder
    Used SLA printer
2016-04-29 Printed the motor holder
    Used Formlabs Form 2 SLA printer. Printing took a tad short of 2 hours with 0.10 mm layer thickness.
2016-05-02 Continue PCB design
2016-05-02 Own PCB
2016-05-03 add final sprocket files and created pcb folder
    [_saved_kellorobo.sch, kellorobo.dsn, kellorobo.kicad_pcb, kellorobo.sch, motor_axle_size_test.fcstd, sprocket.fcstd, sprocket_big_hole.fcstd, sprocket_freewheel.fcstd]
2016-05-03 Some early development on kellorobo code. Looking forward to get it moving by selecting direction with rotary encoder.
2016-05-03 PCB ready with kicad. PCB svg files created for mill. Alignment, FCU, BCU and edges.
    [kellorobo.dsn, kellorobo.sch]
2016-05-03 files for milling
2016-05-03 Assembled the frame
2016-05-03 Assembled frame
2016-05-03 Motor holder support
    A support part for the too flexible motor holder.
2016-05-05 files that used to manufacture the pcb
2016-05-05 Bugfixes to display and rotary encoder.
    [source_code.ino]
2016-05-05 Minor bugfixes and debugging.
    [source_code.ino]
2016-05-05 changed fullbridge pin names
2016-05-05 Debugging rotary encoder
2016-05-05 added pcb/_saved_kellorobo.sch to gitignore
2016-05-11 Removed unnecessary pcb/_saved_kellorobo.sch
    [_saved_kellorobo.sch]
2016-05-11 fixed too long foldername
    [source_code.ino]
2016-05-11 Top lid | UNFINISHED
    Designed the top lid with freecad. UNFINISHED! Needs a hole for alarm on/off switch
    [top_lid_v3.fcstd]
2016-05-26 Top lid finished and printed
2016-05-26 A knob for rotary encoder
    Made with FreeCAD
    [rotary_knob.fcstd, rotary_knob.stl]
2016-05-26 The top lid
    Designed with FreeCAD. The work file might be a bit messed up or laggy since FreeCAD was a "pain in the donkey" once again.
    [toplid_v3-cube.stl, toplid_v3.fcstd]
2016-06-07 Better rotary encoder interrupt function
2016-06-07 rot_but pin fixed
2016-06-12 deleted unnecessary files
    [top_lid_v3.fcstd]
2016-06-26 Assembly of robot and photos
2016-06-29 testin time_alarm library funcs. not working...
    [timealarm.ino]
2016-06-29 Added functions to call when alarm sounds -Drive motors straight and turn when an obstacle is within range
2016-07-08 Bugfix, menu now works as it should, without additional tricks.
    [menu.ino]
2016-07-13 Code cleanup and minor bugfix
    [source_code.ino]
2016-07-19 Added working interrupt code to be integrated
2016-07-19 Added a function to print text while alarm is on
2016-07-19 Some bugfixes. Interrupt enabled for rotary button, but still not fully implemented.
    [source_code.ino]
2016-07-28 Applied interrupt based switch actions. Tweaked turning time constant.
2016-08-03 Added a combined doc of case and mechanics
2016-08-14 Document folder and continuous track doc file
2016-08-14 added doc for pcb
